CARLOSOQUENDO/autoclave-pid-f0/herramientas/pantallas/cerrar.png

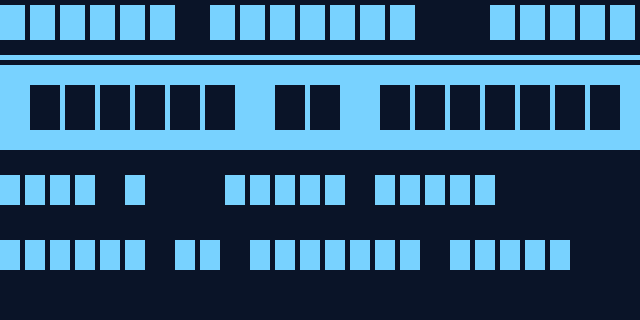
herramientas/pantallas/cerrar.png
