CARLOSOQUENDO/autoclave-pid-f0/herramientas/pantallas/check1.png

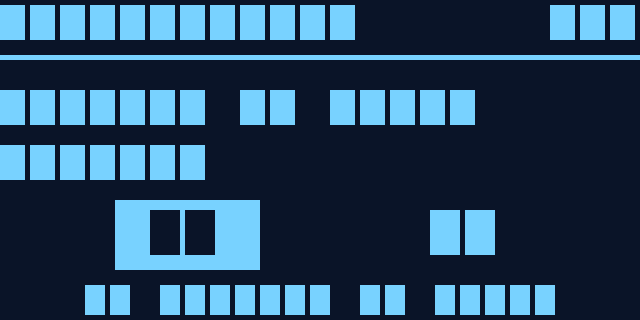
herramientas/pantallas/check1.png
