CARLOSOQUENDO/autoclave-pid-f0/herramientas/pantallas/check2.png

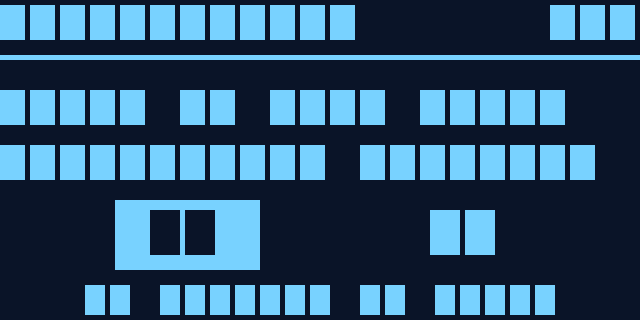
herramientas/pantallas/check2.png
