CARLOSOQUENDO/autoclave-pid-f0/herramientas/pantallas/check4.png

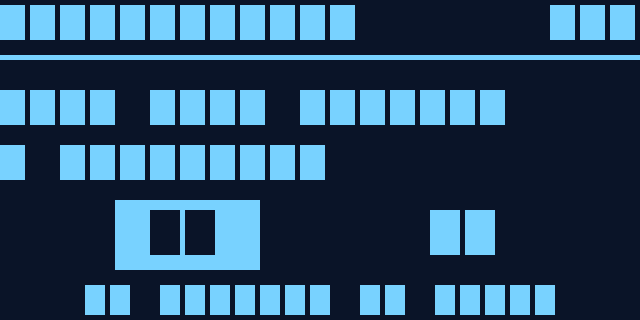
herramientas/pantallas/check4.png
