CARLOSOQUENDO/autoclave-pid-f0/herramientas/pantallas/check5.png

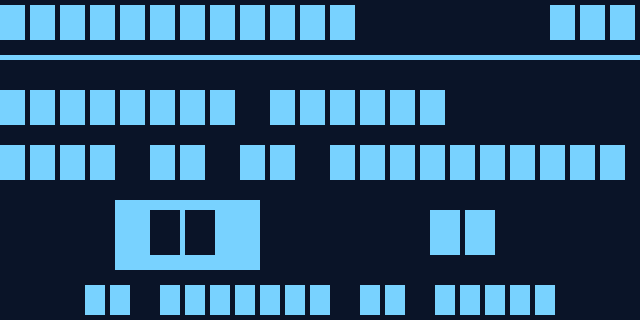
herramientas/pantallas/check5.png
