CARLOSOQUENDO/autoclave-pid-f0/herramientas/pantallas/check6.png

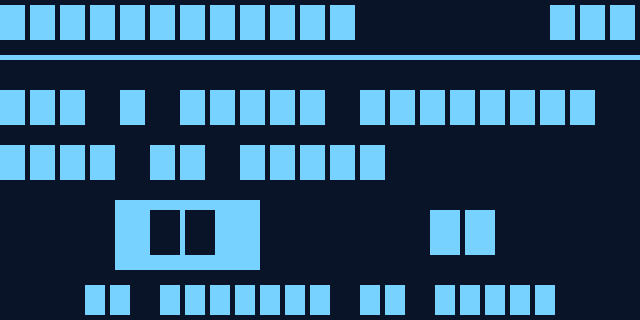
herramientas/pantallas/check6.png
