CARLOSOQUENDO/autoclave-pid-f0/herramientas/pantallas/confirmar.png

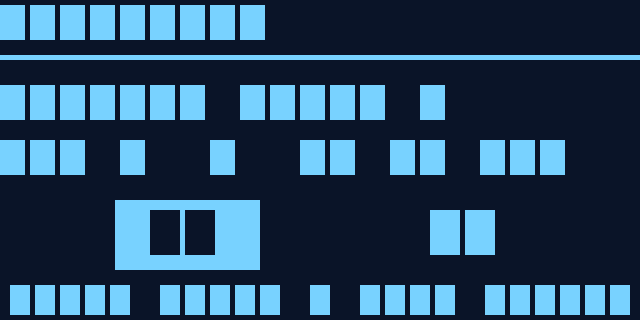
herramientas/pantallas/confirmar.png
