CARLOSOQUENDO/autoclave-pid-f0/herramientas/pantallas/editar.png

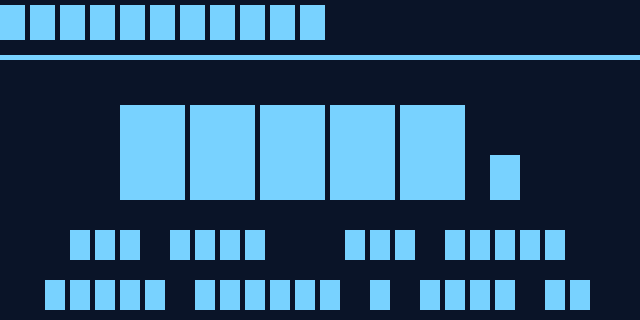
herramientas/pantallas/editar.png
