CARLOSOQUENDO/autoclave-pid-f0/herramientas/pantallas/falla.png

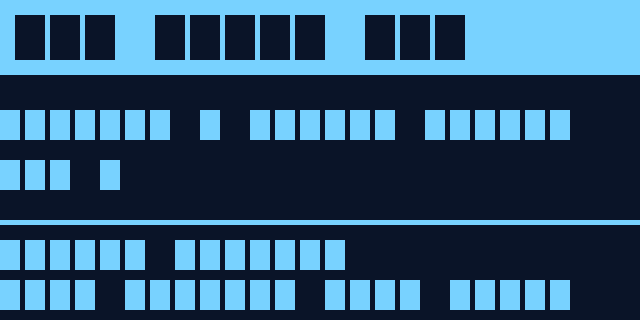
herramientas/pantallas/falla.png
