CARLOSOQUENDO/autoclave-pid-f0/herramientas/pantallas/info.png

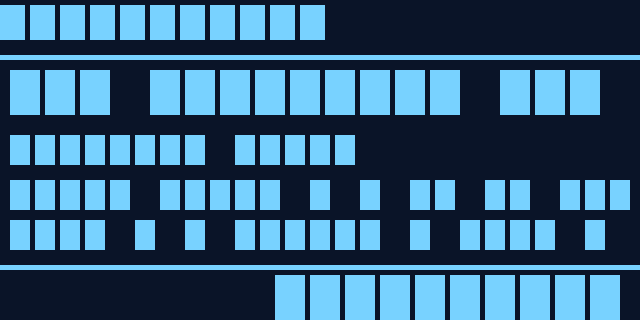
herramientas/pantallas/info.png
