CARLOSOQUENDO/autoclave-pid-f0/herramientas/pantallas/menu.png

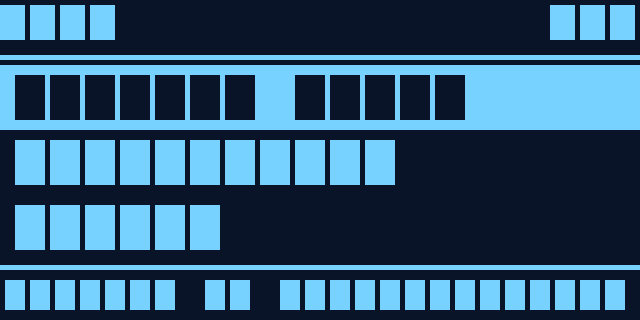
herramientas/pantallas/menu.png
