CARLOSOQUENDO/autoclave-pid-f0/herramientas/pantallas/meseta.png

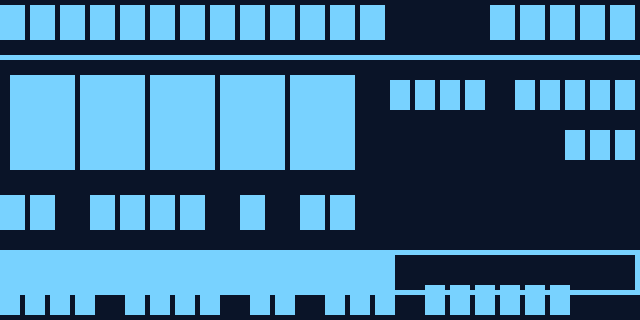
herramientas/pantallas/meseta.png
