CARLOSOQUENDO/autoclave-pid-f0/herramientas/pantallas/principal.png

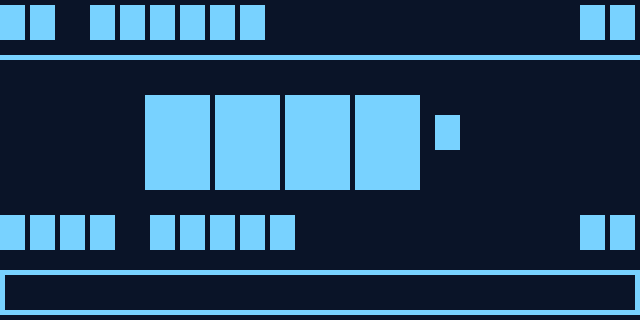
herramientas/pantallas/principal.png
