CARLOSOQUENDO/autoclave-pid-f0/herramientas/pantallas/purga.png

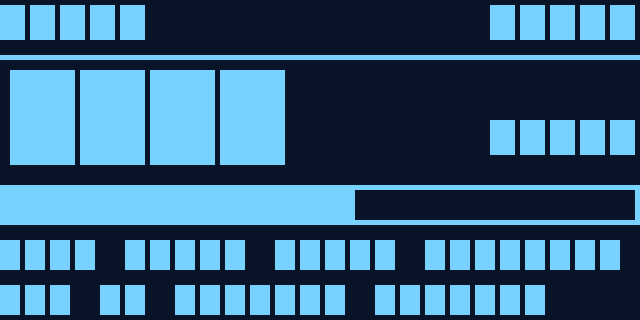
herramientas/pantallas/purga.png
