CARLOSOQUENDO/autoclave-pid-f0/herramientas/pantallas/servicio.png

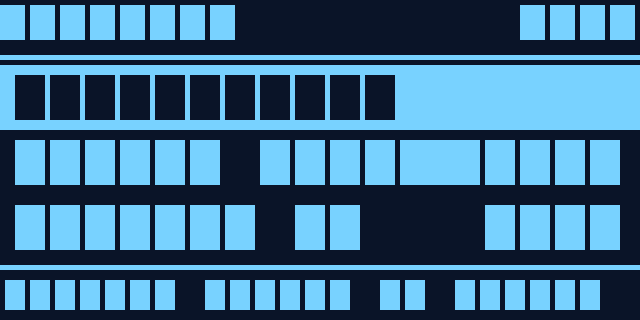
herramientas/pantallas/servicio.png
