CARLOSOQUENDO/autoclave-pid-f0/herramientas/pantallas/calibracion.png

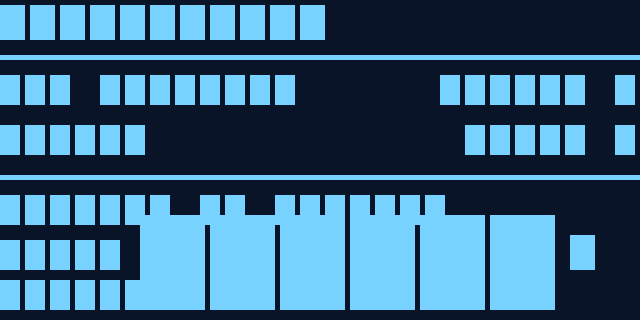
herramientas/pantallas/calibracion.png
