CARLOSOQUENDO/autoclave-pid-f0/herramientas/pantallas/resultados.png

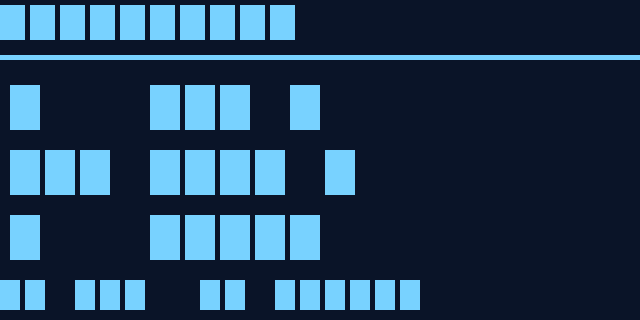
herramientas/pantallas/resultados.png
