CARLOSOQUENDO/autoclave-pid-f0/(commit log)

2026-09-09 Controladora PID para autoclave All American 75X con terminacion por F0
    Firmware ESP32 que convierte un autoclave domestico en un esterilizador de
    proceso validado. El ciclo termina cuando la letalidad acumulada F0 alcanza el
    objetivo, no cuando se cumple un temporizador.
    Motivacion: a 1495 m la escala de temperatura del manometro (calculada para
    nivel del mar) induce a error. El equipo se operaba a 16 psi creyendo estar a
    121 C; la temperatura real eran 119.6 C y un ciclo de 20 min daba F0 ~14 en
    lugar de 20. Con acumulacion de F0 el sistema es inmune a ese error.
    Resultados medidos en ciclo completo:
    - Sobrepaso +0.29 C sobre la consigna
    - Estabilidad en meseta sd 0.012 C
    - Verific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
    [ciclo_121C_rampa_relevo.csv, ciclo_completo_F0_20.csv, ensayo_abortado.csv, pid_110C_cerrada.csv]
2026-09-09 Anadir licencia MIT con aviso de seguridad
    El aviso deja explicito que el firmware controla un recipiente a presion y que
    quien lo adapte sigue siendo responsable de las capas mecanicas, la calibracion
    trazable y la validacion de penetracion en su carga.
2026-09-30 Recalibrar deteccion de marcha en seco tras falsos positivos con carga
    Con sustrato dentro, el ciclo abortaba con "posible marcha en seco: +4.9 C".
    Esa rampa son 0.98 C/min, perfectamente sana para una olla cargada: el umbral
    de 1.0 C/min se habia fijado con la olla vacia y fallaba por 0.1 C.
    Dos correcciones:
    1. Detector lento recalibrado de 5 min/+5 C a 10 min/+2 C. La tasa minima
    exigida baja de 1.00 a 0.20 C/min, que deja margen de 5x sobre la carga mas
    pesada plausible, y ante falta real de calor la temperatura baja (delta
    negativo, inequivoco). Un detector que da falsos positivos acaba puenteado.
    2. Detector rapido especifico de la fase de purga. Con la valvula abierta la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
2026-09-30 Documentar practica real del laboratorio: capas de 20 cm con cinta indicadora
    El laboratorio no esteriliza en capas de 5 cm como planteaba sec.5.1, sino en
    capas de 20 cm con cinta indicadora dentro de la carga. La cinta vira y no ha
    habido incidencias.
    Lo importante es que la cinta de rayas es un indicador ISO 11140 Clase 1: vira
    a ~121 C sin componente de tiempo, en segundos. Demuestra exposicion al
    proceso, no esterilizacion; la propia norma lo dice. Que vire indica que ese
    punto llego a temperatura, no cuanto tiempo la mantuvo, que es justo lo que
    determina la letalidad.
    El espesor importa porque la conduccion escala con el cuadrado de la distancia:
    pasar de 5 a 20 cm multiplica por 16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
2026-09-30 Documentar validacion con indicadores biologicos y ciclo fraccionado
    El laboratorio dispone de indicadores biologicos autocontenidos (esporas de
    G. stearothermophilus con purpura de bromocresol). Son mejor camino para el
    paso 8 que la sonda de penetracion que se habia planteado.
    Motivo: medir temperatura en el centro y calcular F0 supone que el modelo de
    letalidad con z=10 C describe bien lo que pasa ahi. El indicador biologico no
    supone nada: integra por si mismo penetracion de vapor, temperatura y tiempo, y
    responde directamente a si la esterilizacion llega al centro de 20 cm.
    Requisito no negociable documentado: control positivo sin procesar del mismo
    lote. Si no vira a amarillo, las es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
2026-09-30 Hacer configurable el tiempo de purga y documentar como decidirlo
    Para la camara sola 7 minutos sobran: a 1680 W se generan 1.55 L/s de vapor y
    el volumen libre (~23 L) se renueva cada 15 s, o sea 28 veces en 7 minutos.
    Pero el aire dificil no esta en la camara sino en los poros de la carga, y un
    lecho de 20 cm no se purga por renovacion de volumen sino por difusion a traves
    del lecho. Eso no se puede calcular. Ademas la valvula esta en la tapa, no
    abajo como en un desplazamiento por gravedad bien hecho, y el estandar para
    estos recipientes son 10 minutos.
    La purga insuficiente no falla de forma visible: deja bolsas de aire donde el
    vapor no penetra y la PT100 del termowell no se entera. P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
2026-09-30 Cronometro del proceso, arreglar solape en purga y actualizar checklist
    Cuatro ajustes pedidos tras usar el equipo en ciclos reales.
    1. La purga vuelve a ser constante fija de 7 min. Se habia hecho ajustable en
    el commit anterior y se revierte a proposito: no es un parametro para tocar
    a ojo, porque la purga insuficiente no da ninguna senal. Solo el test con
    indicador biologico justificaria revisarla.
    2. Cronometro del ciclo completo en la cabecera, que se congela al completarse
    la esterilizacion: interesa la duracion del proceso, no la del enfriamiento.
    Antes cada pantalla mostraba solo el tiempo de su fase y no habia forma de
    saber cuanto llevaba el ciclo. La temperatur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
    [04_caracterizacion.ino]
2026-09-30 Reducir el menu a lo esencial y revisar toda la interfaz con el operador
    Peticion: no dejar puertas abiertas para que un operador cambie cosas criticas.
    Empezo por quitar la calibracion y se amplio, porque quitar solo eso se quedaba
    corto: MODO MANUAL y ENSAYO ESCALON son mas peligrosos (aplican calor sin la
    gobernanza del ciclo) y LETALIDAD F0 estaba en el menu del operador, a dos
    clics. Bajarlo de 20 a 5 sub-esteriliza sin que nada lo delate.
    El menu del operador queda en tres entradas: INICIAR CICLO, INFORMACION,
    VOLVER. El resto pasa a consola, que exige un PC y por tanto la presencia del
    tecnico. Los parametros se muestran en INFORMACION en solo lectura: ver sin
    poder cambiar.
    Las her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
2026-09-30 Separar la FALLA en recuperable y critica, que no se borra sin revision
    La pulsacion larga borraba cualquier falla por igual, incluida la de superar
    128 C. El razonamiento que dejo eso asi estaba mal en tres puntos:
    - "Reconocer no es rearmar" era verdad irrelevante: desde EST_IDLE el
    operador entra a INICIAR CICLO y lanzarCiclo() rearma la salida. Pulsacion
    larga + menu = ciclo nuevo sin que nadie diagnostique nada.
    - Superar el limite absoluto y agotar el tiempo maximo se trataban igual, y
    el primero significa que el SSR conduce sin orden o el control se desboco.
    - El argumento de "sin PC quedarian atrapados" no se sostiene: la falla corta
    la salida y la olla se enfria sola. Borra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
2026-10-01 Arreglar los avisos del final del ciclo y espaciar el reaviso de abrir
    Cumplir el F0 era mudo: el hito mas importante del proceso no sonaba y el
    operador se enteraba solo si estaba mirando la pantalla.
    La melodia de fin estaba atada a que el operador descartara el aviso en
    F_TERMINADO, no al F0 cumplido. Como nada lleva a EST_IDLE automaticamente,
    sonaba al cerrar el "NO ABRIR - AUN HAY PRESION" y se quedaba muda al cerrar
    el "DESPRESURIZADO": celebraba el momento peligroso y callaba el seguro. Y de
    paso reponia g_vista = V_CICLO justo despues de que la pulsacion larga habia
    puesto V_PRINCIPAL, asi que en F_TERMINADO la pulsacion no cerraba nada.
    Ahora la melodia la desata el F0 cumplido y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
    [04_caracterizacion.ino]
2026-10-01 Agregar probarfalla y verificar el enclavamiento en el hardware real
    El limite absoluto no se puede falsear desde la calibracion: el offset esta
    topado en +/-3 C y el corte compara fmaxf(lectura corregida, cruda), asi que
    un offset mal ajustado solo puede bajar el punto de corte, nunca subirlo. La
    otra entrada critica exigiria desconectar la sonda con la resistencia
    energizada. Quedaba calentar la olla a 128 C de verdad, absurdo como prueba
    rutinaria.
    'probarfalla' lanza una falla critica desde la consola. Es permanente, no
    andamiaje: un enclavamiento que no se puede probar es un enclavamiento que no
    se sabe si funciona, y hay que poder reverificarlo tras cada cambio de
    firmware. Queda fuer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
2026-10-01 Recorrer los seis avisos en el comando sonido
    Incluye la melodia de fin de ciclo, que antes solo se podia oir corriendo un
    ciclo completo hasta cumplir el F0. Ahora el orden del recorrido es el de
    gravedad creciente, que es el criterio con el que se eligieron los tonos.
2026-10-01 Verificar el watchdog y reportar el motivo de cada arranque
    El watchdog estaba configurado desde el paso 0 y nunca se habia comprobado que
    disparara. Una proteccion configurada y no probada es una suposicion.
    'probarwdt' cuelga tareaSalida a proposito, cortando el SSR antes: una tarea
    colgada con el SSR conduciendo son 8 segundos de resistencia sin vigilancia, y
    la prueba no tiene por que incluir eso.
    Medido el 2026-10-01 con la olla fria: 8.1 s entre el cuelgue y el disparo
    contra WDT_TIMEOUT_MS = 8000, y nombro exactamente la tarea suscrita,
    "salida (CPU 1)". Tras el reinicio el equipo quedo en IDLE, salida desarmada,
    sensor OK y registro de fallas limpio. Confirma de paso que solo tarea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
